ZioGuido/MidiMotorFader/pics/20191002_231942.jpg

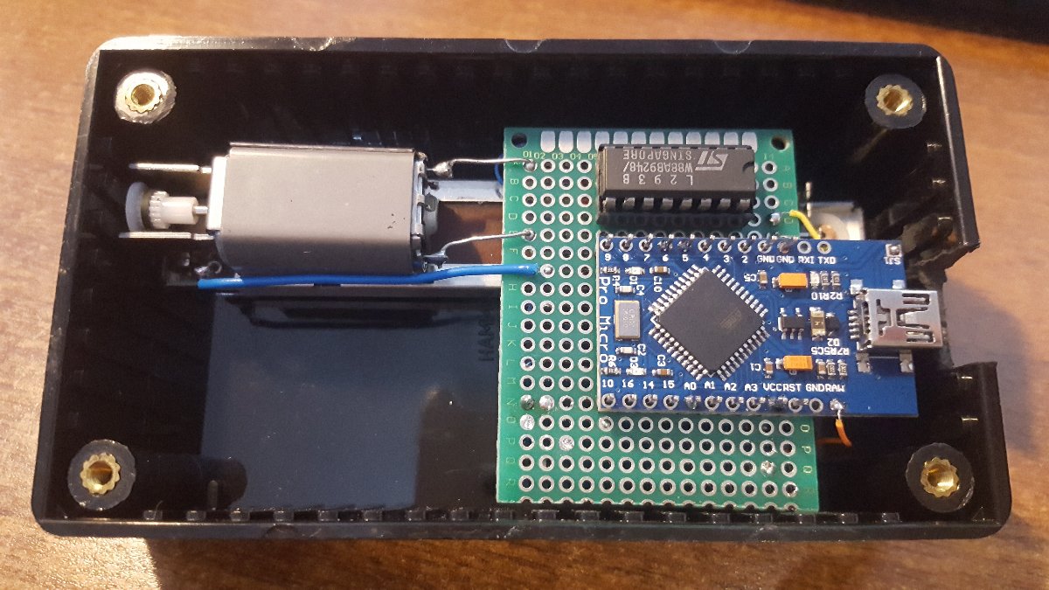
pics/20191002_231942.jpg
