ZioGuido/MidiMotorFader/pics/stepup.jpg

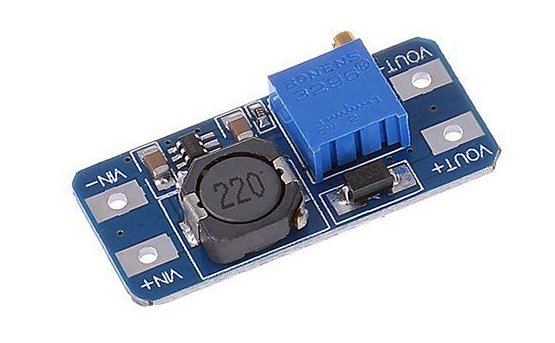
pics/stepup.jpg
