ZioGuido/MidiMotorFader/Arduino_USB_Motorfader.png

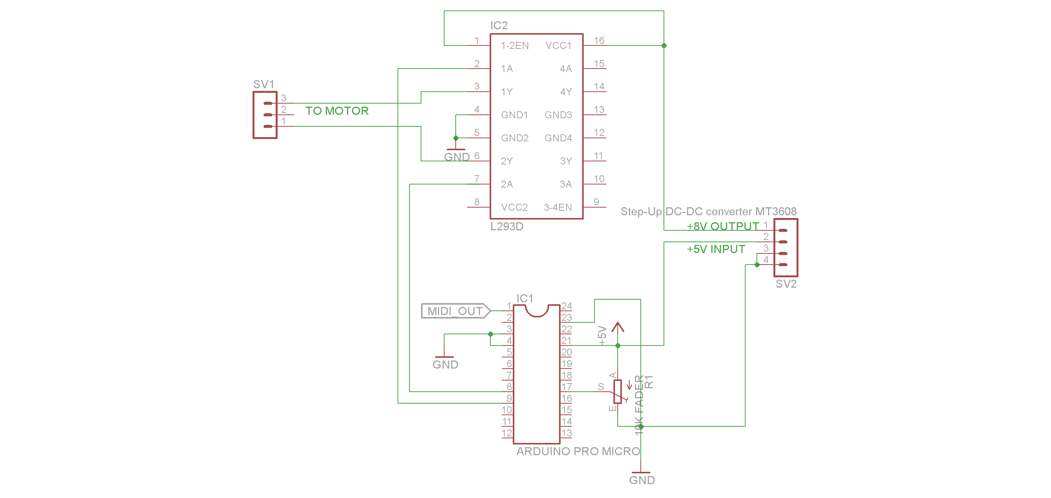
Arduino_USB_Motorfader.png
