ZioGuido/MidiMotorFader/pics/20191002_231920.jpg

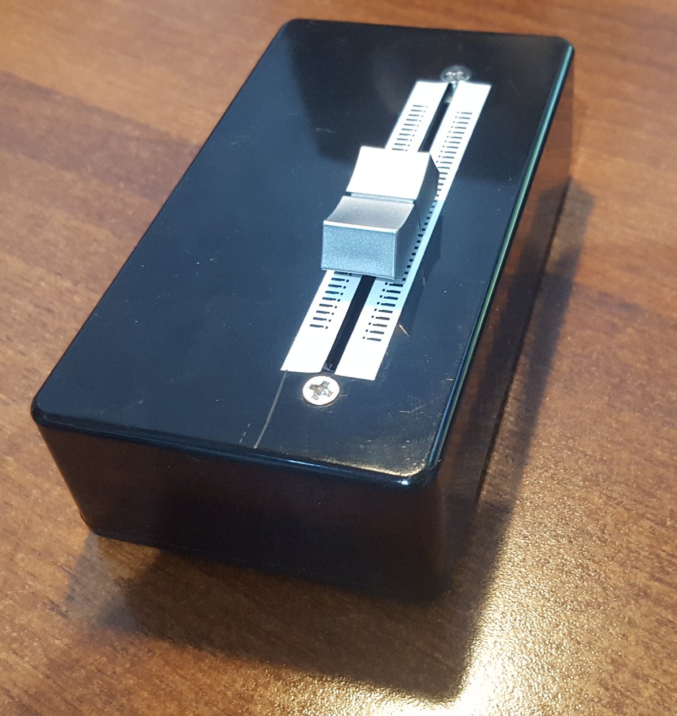
pics/20191002_231920.jpg
